lucysrausch/esp32-led-smps/3d/804-102.stp

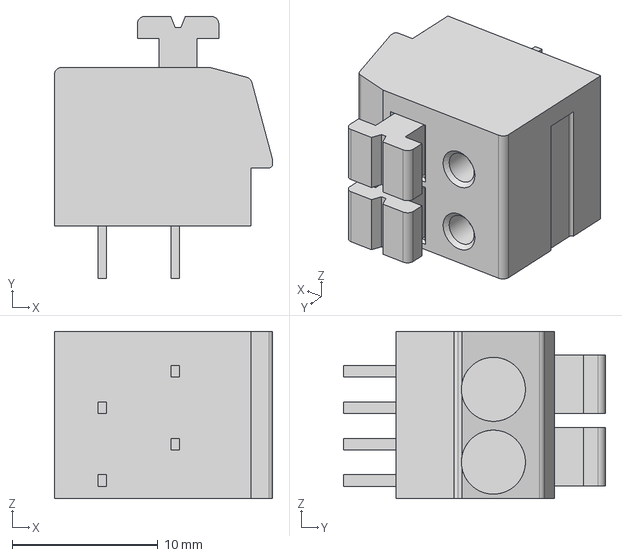
[picture p1: CAD file, 2020-04-05]
3d/804-102.stp
15.0 x 18.0 x 11.5 mm
