lucysrausch/esp32-led-smps/3d/804-103.stp

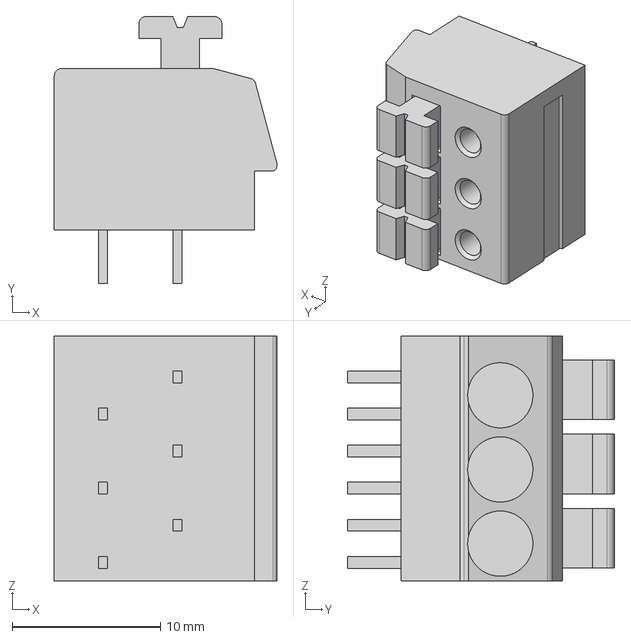
[picture p2: CAD file, 2020-04-05]
3d/804-103.stp
15.0 x 18.0 x 16.5 mm
