lucysrausch/esp32-led-smps/3d/User Library-EE25_13_7_ferrite_transformer.STEP

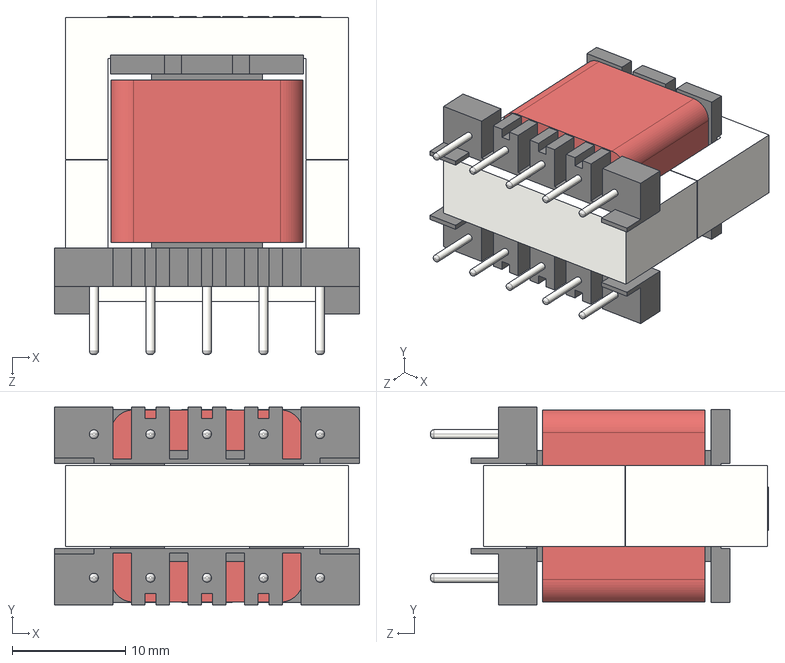
[picture p3: CAD file, 2020-04-05]
3d/User Library-EE25_13_7_ferrite_transformer.STEP
27.0 x 17.5 x 29.9 mm
