lucysrausch/esp32-led-smps/3d/radial fuse.stp

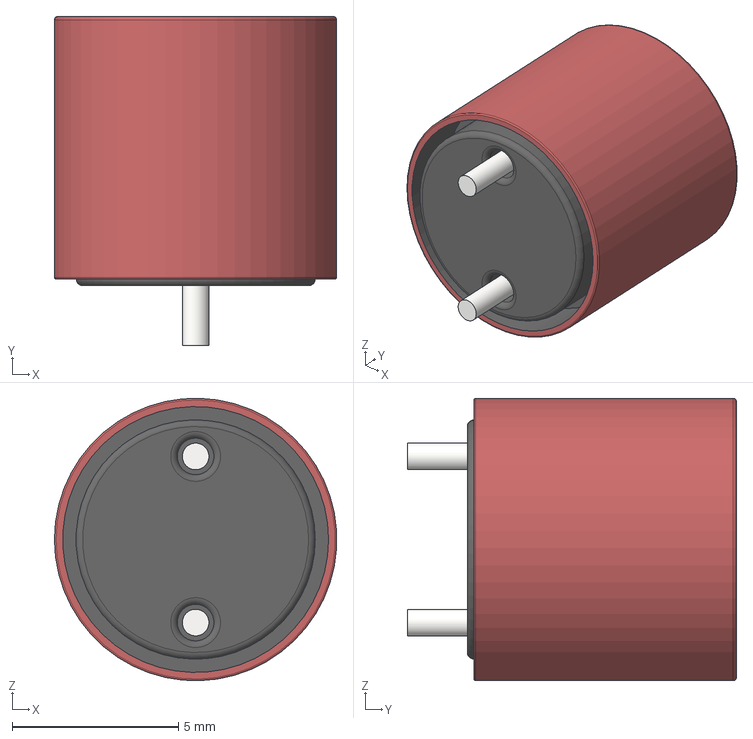
[picture p4: CAD file, 2020-04-05]
3d/radial fuse.stp
8.49 x 9.90 x 8.50 mm
