lucysrausch/esp32-led-smps/3d/User Library-UU10_5.STEP

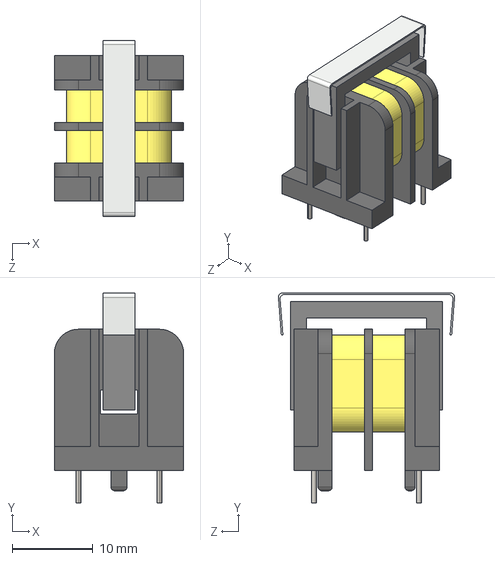
[picture p5: CAD file, 2020-04-05]
3d/User Library-UU10_5.STEP
16.0 x 26.0 x 21.8 mm
