lucysrausch/esp32-led-smps/schematic/main.pdf

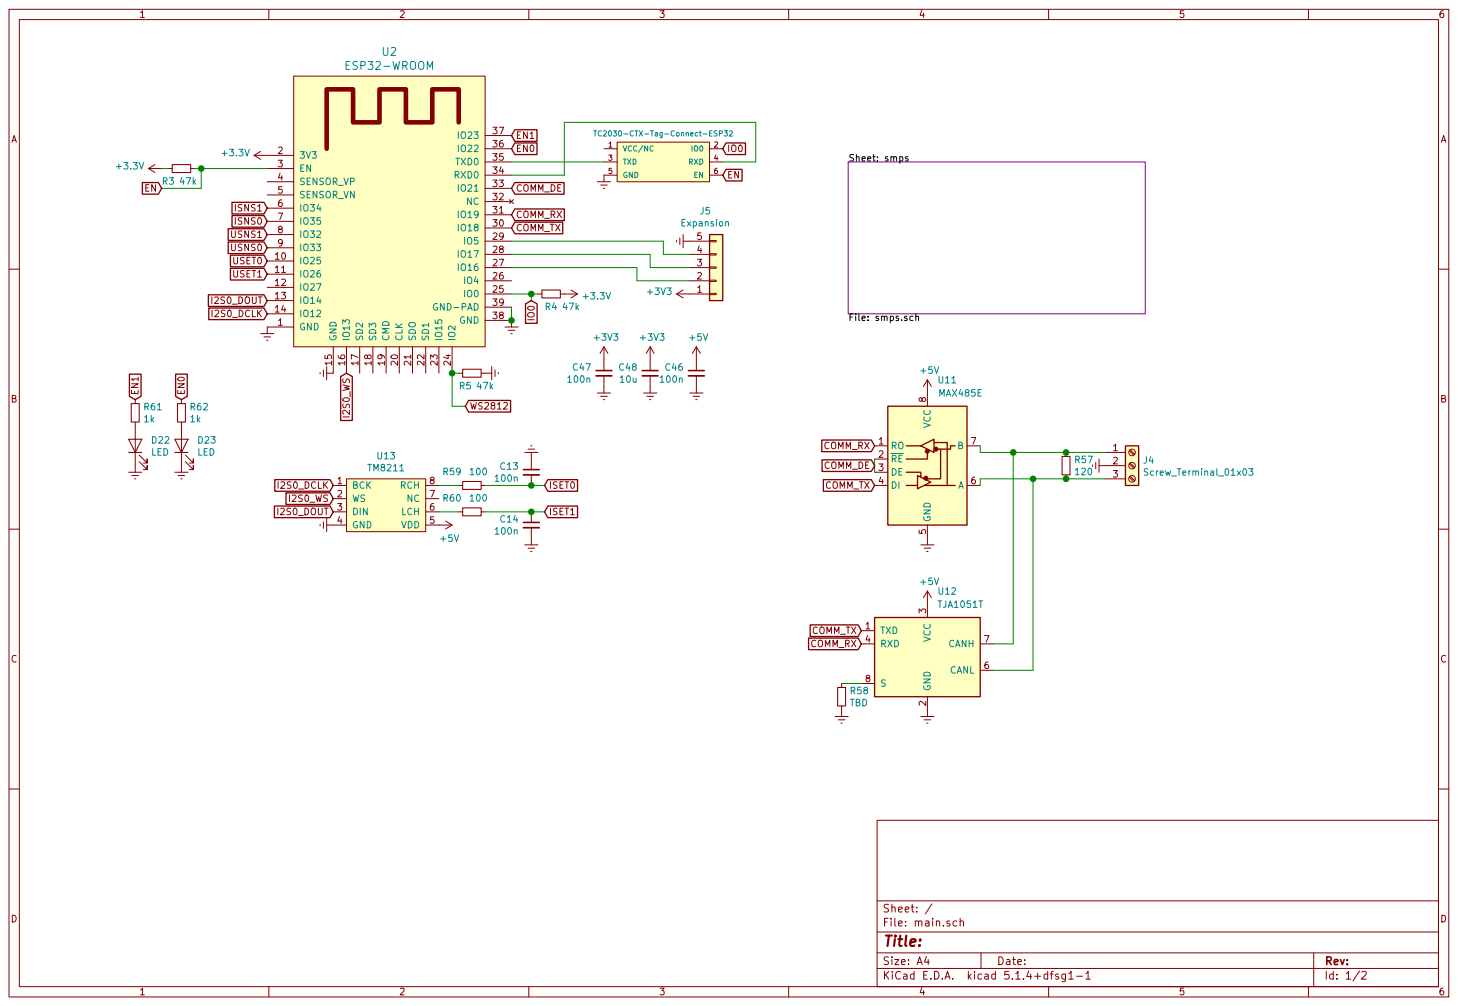
[picture p6: page 1]

Id: 1/2 Title: File: main.sch Sheet: /

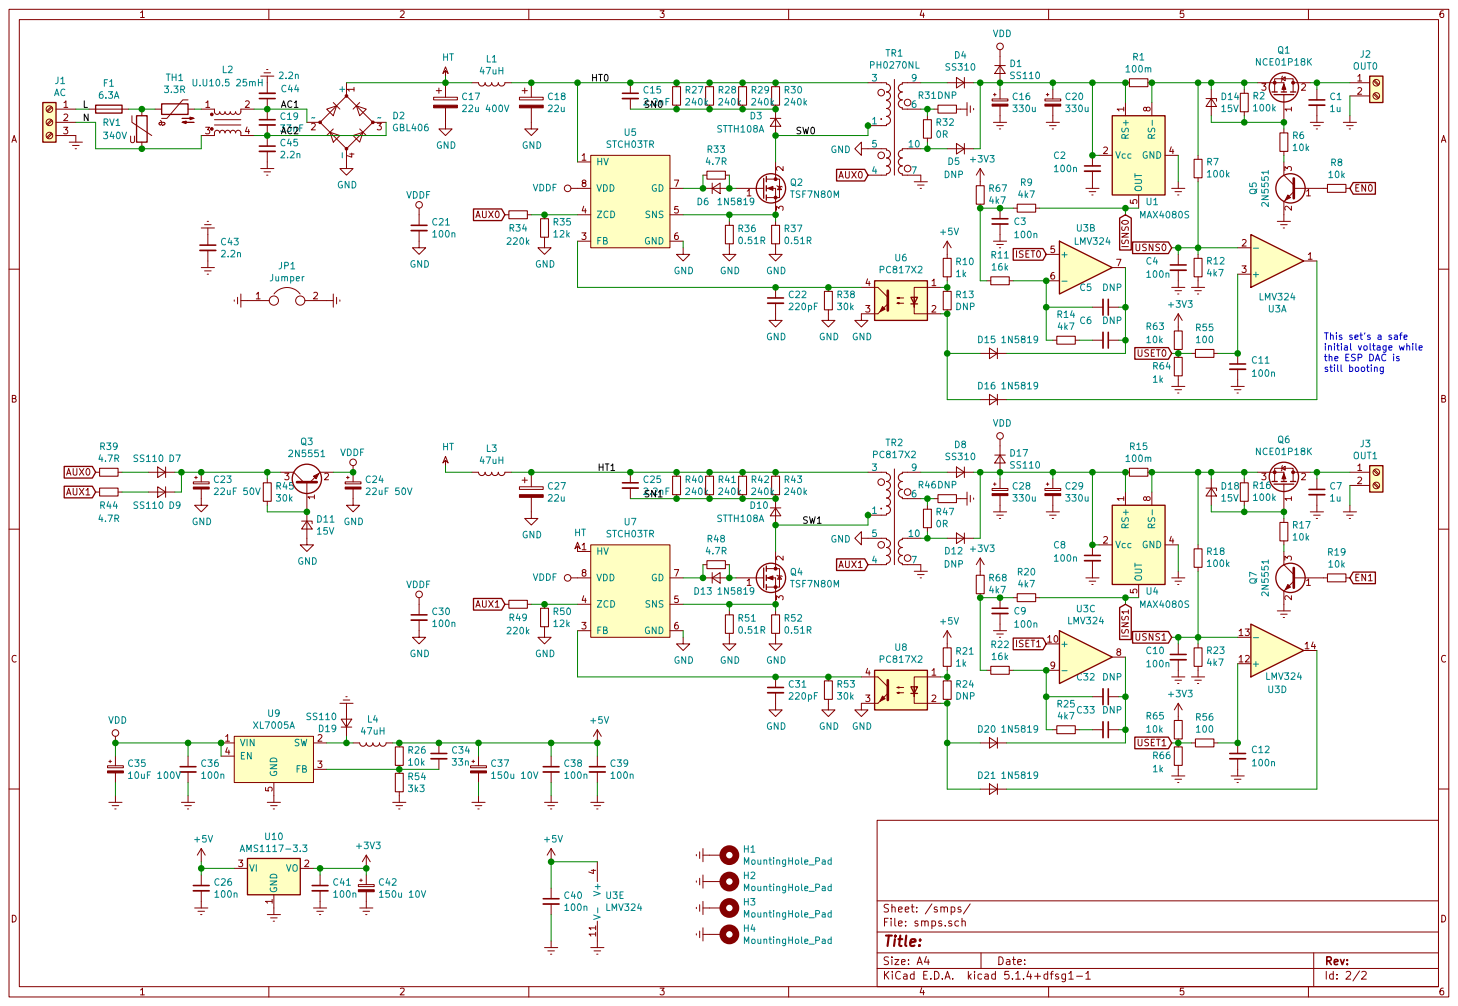
[picture p7: page 2]

initial voltage while
the ESP DAC is still booting

1 VO 2 VI 3 U10 AMS1117-3.3 GND GND
