lucysrausch/esp32-led-smps/main.kicad_pcb

## KiCad design main.kicad_pcb (2020-04-05)

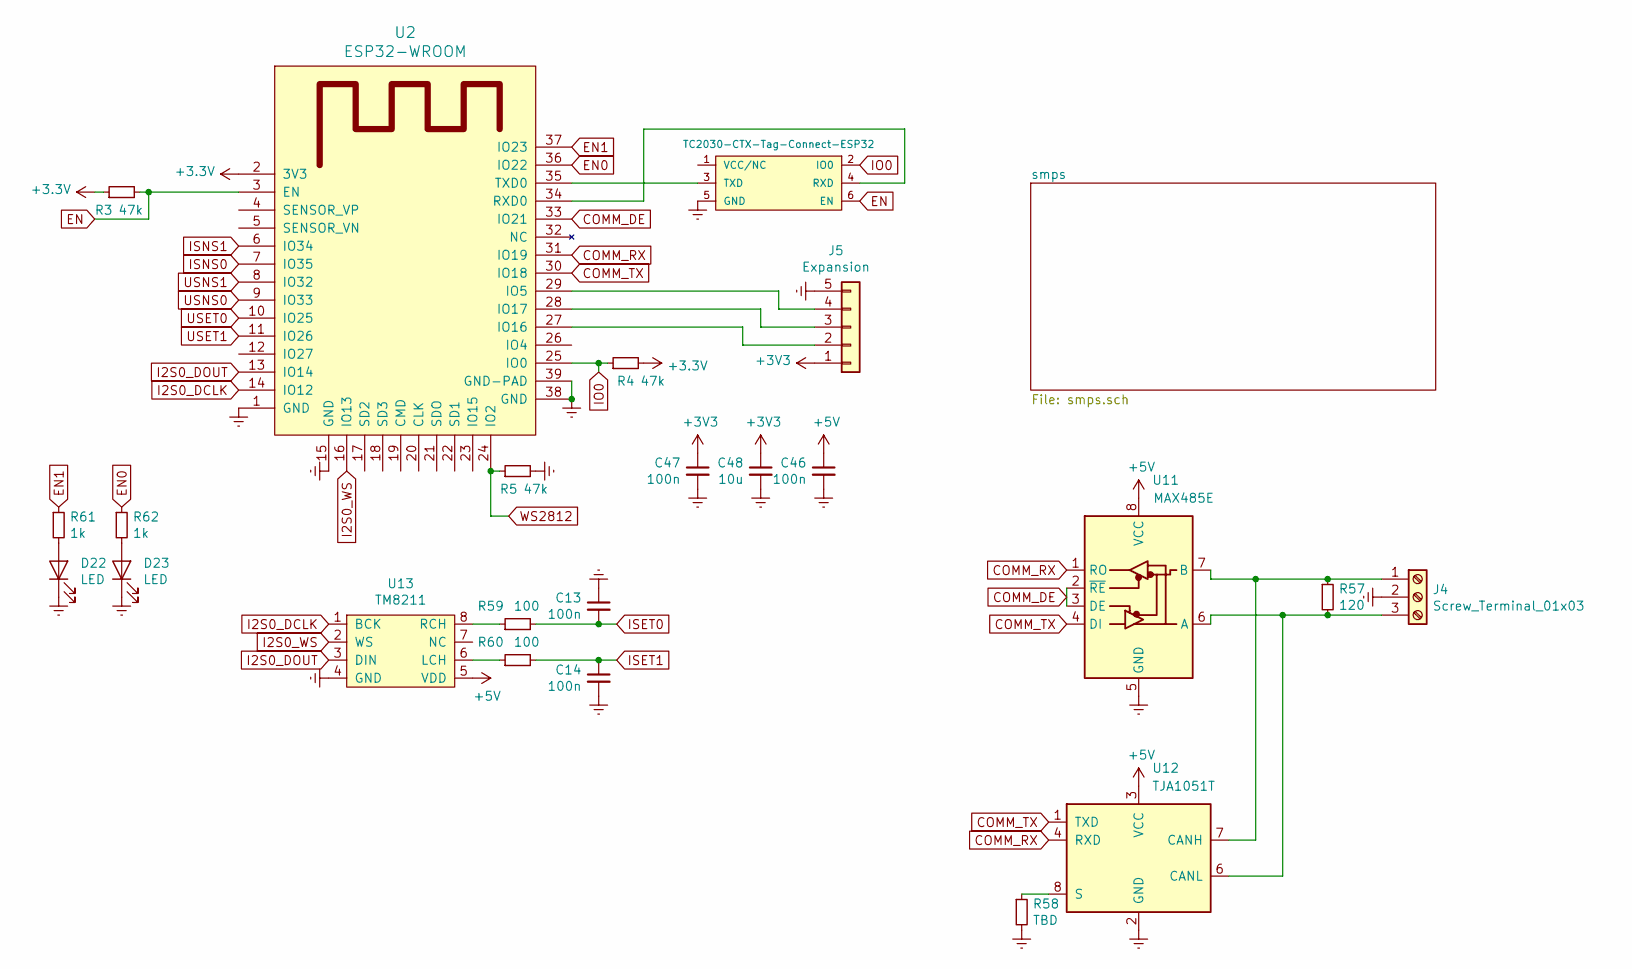
[picture p8: schematic main.sch]

Parts:
C13, C14, C46, C47: 100n; C_0603_1608Metric
C48: 10u; C_0603_1608Metric
D22, D23: LED; LED_0603_1608Metric
J4: Screw_Terminal_01x03; TerminalBlock_MetzConnect_Type086_RT03403HBLC_1x03_P3.81mm_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
J5: Expansion; PinSocket_1x05_P2.54mm_Vertical
P1: TC2030-CTX-Tag-Connect-ESP32; TC2030
R3, R4, R5: 47k; R_0603_1608Metric
R57: 120; R_0603_1608Metric
R58: TBD; R_0603_1608Metric
R59, R60: 100; R_0603_1608Metric
R61, R62: 1k; R_0603_1608Metric
U2: ESP32-WROOM; ESP32-WROOM-32
U11: MAX485E; SOIC-8_3.9x4.9mm_P1.27mm
U12: TJA1051T; SOIC-8_3.9x4.9mm_P1.27mm
U13: TM8211; SOIC-8_3.9x4.9mm_P1.27mm

Connections:
+5V: C46.1, U11.8 (VCC), U12.3 (VCC), U13.5 (VDD); also elsewhere on the board
COMM_DE: U2.33 (IO21), U11.2 (~RE), U11.3 (DE)
COMM_RX: U2.31 (IO19), U11.1 (RO), U12.4 (RXD)
COMM_TX: U2.30 (IO18), U11.4 (DI), U12.1 (TXD)
EN: P1.6 (EN), R3.2, U2.3 (EN)
EN0: R62.1, U2.36 (IO22); also elsewhere on the board
EN1: R61.1, U2.37 (IO23); also elsewhere on the board
Earth: C13.1, C14.2, C46.2, C47.2, C48.2, D22.1 (K), D23.1 (K), J4.2, J5.5, P1.5 (GND), R5.2, R58.2, U2.1 (GND), U2.15 (GND), U2.38 (GND), U2.39 (GND-PAD), U11.5 (GND), U12.2 (GND), U13.4 (GND); also elsewhere on the board
I2S0_DCLK: U2.14 (IO12), U13.1 (BCK)
I2S0_DOUT: U2.13 (IO14), U13.3 (DIN)
I2S0_WS: U2.16 (IO13), U13.2 (WS)
IO0: P1.2 (IO0), R4.1, U2.25 (IO0)
ISET0: C13.2, R59.2; also elsewhere on the board
ISET1: C14.1, R60.2; also elsewhere on the board
ISNS0: U2.7 (IO35); also elsewhere on the board
ISNS1: U2.6 (IO34); also elsewhere on the board
unnamed: D22.2 (A), R61.2
unnamed: D23.2 (A), R62.2
unnamed: J4.1, R57.1, U11.7 (B), U12.7 (CANH)
unnamed: J4.3, R57.2, U11.6 (A), U12.6 (CANL)
unnamed: J5.2, U2.27 (IO16)
unnamed: J5.3, U2.28 (IO17)
unnamed: J5.4, U2.29 (IO5)
unnamed: P1.3 (TXD), U2.35 (TXD0)
unnamed: P1.4 (RXD), U2.34 (RXD0)
unnamed: R58.1, U12.8 (S)
unnamed: R59.1, U13.8 (RCH)
unnamed: R60.1, U13.6 (LCH)
USET0: U2.10 (IO25); also elsewhere on the board
USET1: U2.11 (IO26); also elsewhere on the board
USNS0: U2.9 (IO33); also elsewhere on the board
USNS1: U2.8 (IO32); also elsewhere on the board
WS2812: R5.1, U2.24 (IO2)

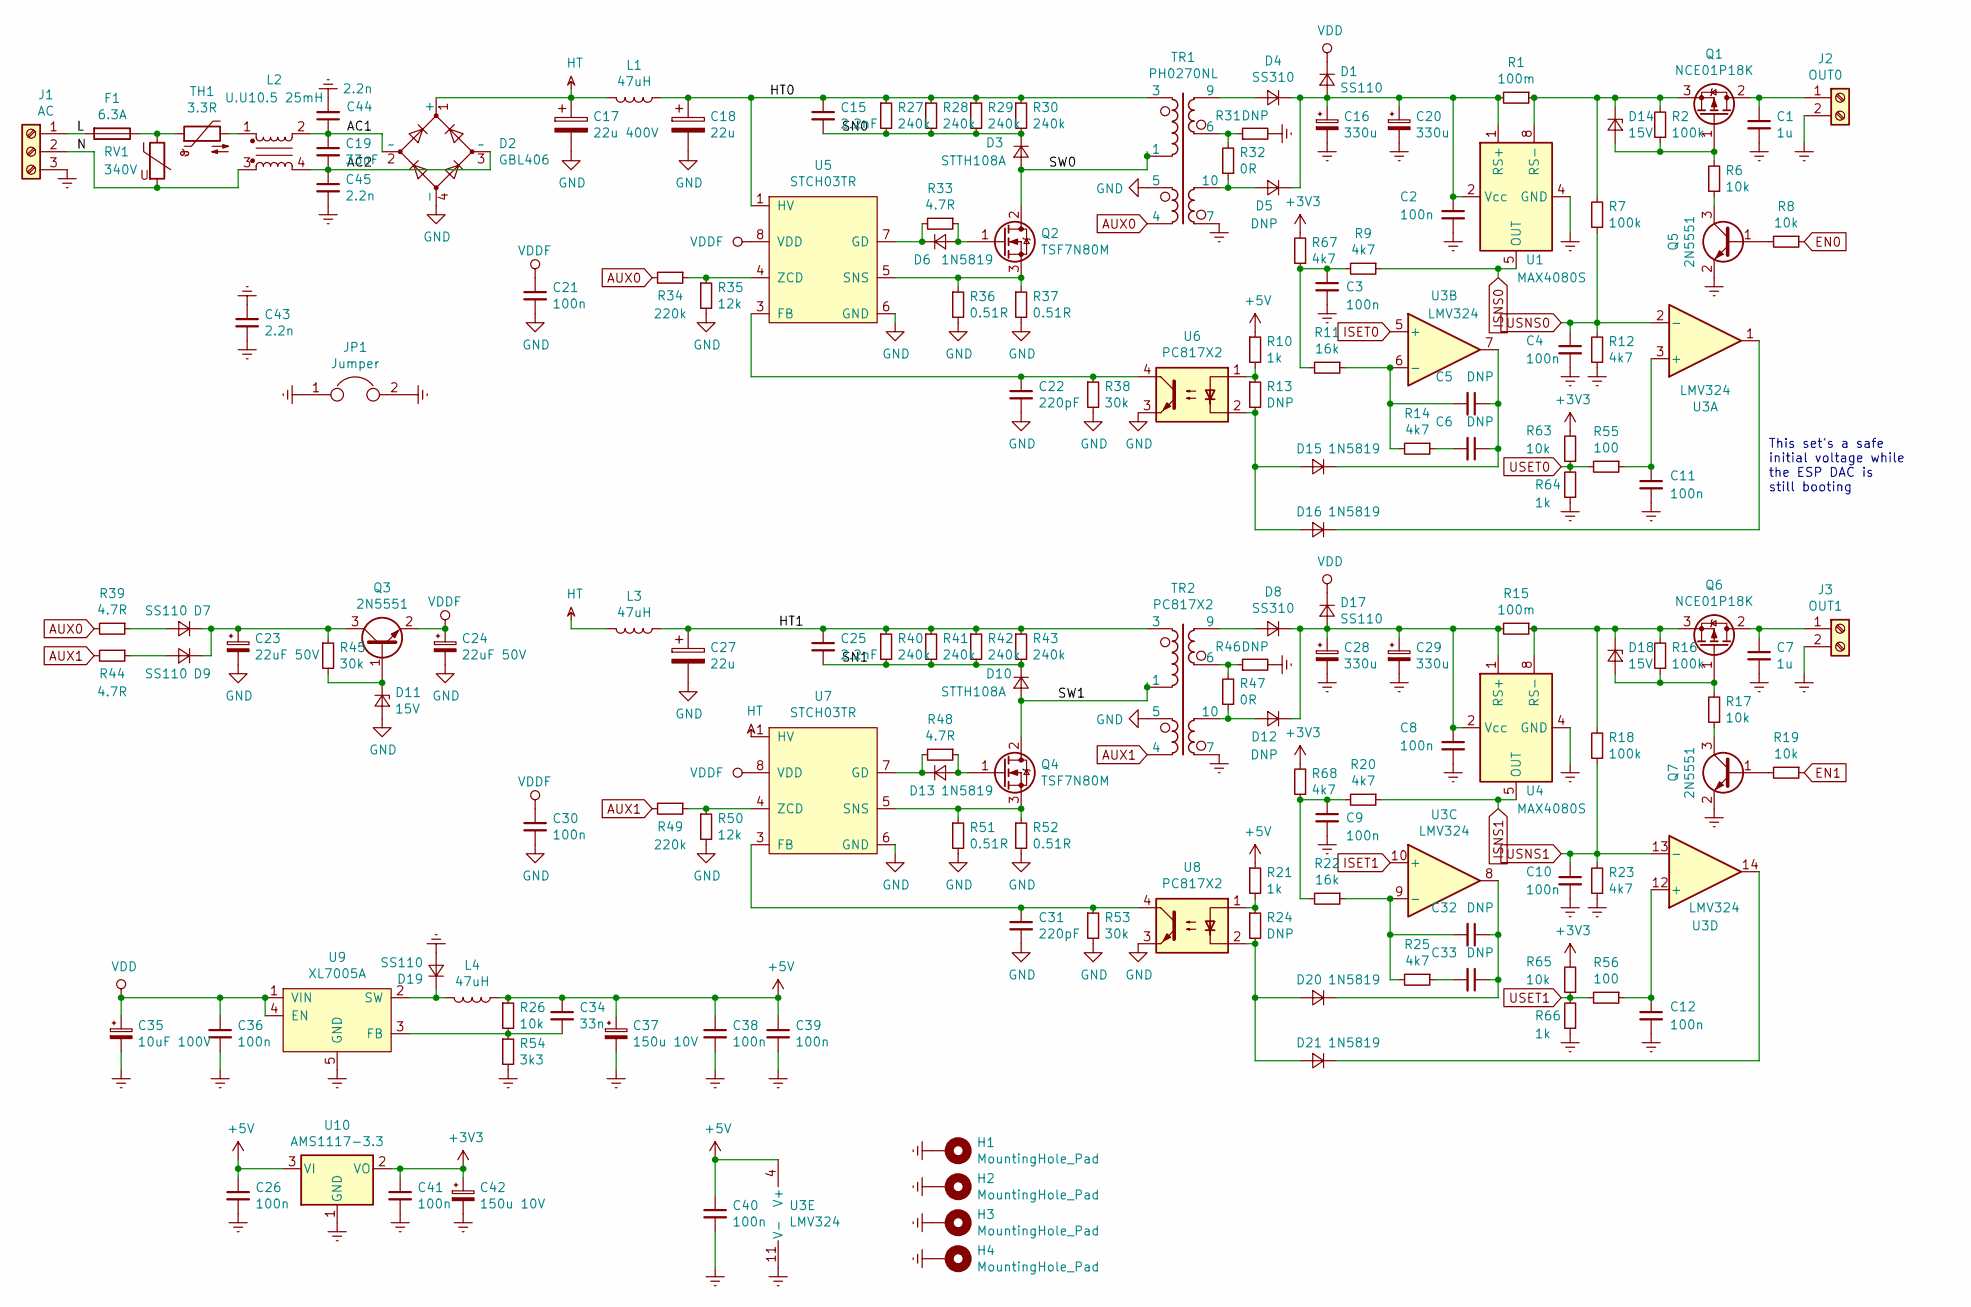
[picture p9: schematic smps.sch]

Parts:
C1, C7: 1u; C_Rect_L7.2mm_W5.5mm_P5.00mm_FKS2_FKP2_MKS2_MKP2
C2, C8, C36: 100n; C_0805_2012Metric
C3, C4, C9, C10, C11, C12, C21, C26, C30, C38, C39, C40, C41: 100n; C_0603_1608Metric
C5, C6, C32, C33: DNP; C_0603_1608Metric
C15, C25: 2.2nF; C_1206_3216Metric
C16, C20, C28, C29: 330u; CP_Radial_D16.0mm_P7.50mm
C17: 22u 400V; CP_Radial_D16.0mm_P7.50mm
C18, C27: 22u; CP_Radial_D16.0mm_P7.50mm
C19: 33nF; C_Rect_L16.5mm_W6.0mm_P15.00mm_MKT
C22, C31: 220pF; C_0603_1608Metric
C23, C24: 22uF 50V; CP_Radial_D5.0mm_P2.00mm
C34: 33n; C_0603_1608Metric
C35: 10uF 100V; CP_Radial_D5.0mm_P2.00mm
C37, C42: 150u 10V; CP_Radial_D5.0mm_P2.00mm
C43, C44, C45: 2.2n; RV_Disc_D9mm_W4mm_P5mm
D1, D7, D9, D17, D19: SS110; D_SMA
D2: GBL406; Diode_Bridge_Vishay_GBL
D3, D10: STTH108A; D_SMA
D4, D8: SS310; D_SMA
D5, D12: DNP; D_SMA
D6, D13, D15, D16, D20, D21: 1N5819; D_SOD-123
D11, D14, D18: 15V; D_SOD-123
F1: 6.3A; Fuseholder_TR5_Littelfuse_No560_No460
H1, H2, H3, H4: MountingHole_Pad; MountingHole_3.5mm_Pad_Via
J1: AC; WJ250B-3.5-3P
J2: OUT0; WJ250B-3.5-2P
J3: OUT1; WJ250B-3.5-2P
JP1: Jumper
L1, L3, L4: 47uH; L_Radial_D7.0mm_P3.00mm
L2: U.U10.5 25mH; L_CommonMode_U.U_multi
Q1, Q6: NCE01P18K; TO-252-2
Q2, Q4: TSF7N80M; TO-220-3_Vertical
Q3, Q5, Q7: 2N5551; SOT-23
R1, R15: 100m; R_1206_3216Metric
R2, R7, R16, R18: 100k; R_0603_1608Metric
R6, R8, R17, R19, R26, R63, R65: 10k; R_0603_1608Metric
R9, R12, R14, R20, R23, R25, R67, R68: 4k7; R_0603_1608Metric
R10, R21, R64, R66: 1k; R_0603_1608Metric
R11, R22: 16k; R_0603_1608Metric
R13, R24, R31, R46: DNP; R_0603_1608Metric
R27, R28, R29, R30, R40, R41, R42, R43: 240k; R_1206_3216Metric
R32, R47: 0R; R_0603_1608Metric
R33, R39, R44, R48: 4.7R; R_0603_1608Metric
R34, R49: 220k; R_0603_1608Metric
R35, R50: 12k; R_0603_1608Metric
R36, R37, R51, R52: 0.51R; R_1206_3216Metric
R38, R45, R53: 30k; R_0603_1608Metric
R54: 3k3; R_0603_1608Metric
R55, R56: 100; R_0603_1608Metric
RV1: 340V; RV_Disc_D12mm_W5.1mm_P7.5mm
TH1: 3.3R; RV_Disc_D12mm_W3.9mm_P7.5mm
TR1: PH0270NL; Pulse_PH027NL
TR2: PC817X2; Pulse_PH027NL
U1, U4: MAX4080S; SOIC-8_3.9x4.9mm_P1.27mm
U3: LMV324; SOIC-14_3.9x8.7mm_P1.27mm
U5, U7: STCH03TR; SOIC-8_3.9x4.9mm_P1.27mm
U6, U8: PC817X2; DIP-4_W7.62mm
U9: XL7005A; SOIC-8-1EP_3.9x4.9mm_P1.27mm_EP2.514x3.2mm
U10: AMS1117-3.3; SOT-223-3_TabPin2

Connections:
+5V: C26.1, C34.1, C37.1, C38.1, C39.1, C40.1, L4.1, R10.1, R21.1, R26.1, U3.4 (V+), U10.3 (VI); also elsewhere on the board
/smps/AC1: C19.1, C44.1, D2.2 (~~), L2.2
/smps/AC2: C19.2, C45.1, D2.3 (~~), L2.4
/smps/HT0: C15.1, C18.1, L1.1, R27.1, R28.1, R29.1, R30.1, TR1.3, U5.1 (HV)
/smps/HT1: C25.1, C27.1, L3.1, R40.1, R41.1, R42.1, R43.1, TR2.3
/smps/L: F1.2, J1.1
/smps/N: J1.2, L2.3, RV1.2
/smps/SN0: C15.2, D3.1 (K), R27.2, R28.2, R29.2, R30.2
/smps/SN1: C25.2, D10.1 (K), R40.2, R41.2, R42.2, R43.2
/smps/SW0: D3.2 (A), Q2.2 (D), TR1.1
/smps/SW1: D10.2 (A), Q4.2 (D), TR2.1
AUX0: R34.2, R39.2, TR1.4
AUX1: R44.2, R49.2, TR2.4
EN0: R8.1; also elsewhere on the board
EN1: R19.1; also elsewhere on the board
Earth: C1.2, C2.2, C3.2, C4.2, C7.2, C8.2, C9.2, C10.2, C11.2, C12.2, C16.2, C20.2, C26.2, C28.2, C29.2, C35.2, C36.2, C37.2, C38.2, C39.2, C40.2, C41.2, C42.2, C43.1, C43.2, C44.2, C45.2, D19.2 (A), H1.1, H2.1, H3.1, H4.1, J1.3, J2.2, J3.2, JP1.1, JP1.2, Q5.2 (E), Q7.2 (E), R12.1, R23.1, R31.2, R46.2, R54.2, R64.1, R66.1, TR1.7, TR2.7, U1.4 (GND), U3.11 (V-), U4.4 (GND), U9.5 (GND), U9.6 (GND), U9.7 (GND), U9.8 (GND), U9.9 (GND), U10.1 (GND); also elsewhere on the board
GND: C17.2, C18.2, C21.2, C22.2, C23.2, C24.2, C27.2, C30.2, C31.2, D2.4 (-), D11.2 (A), R35.2, R36.2, R37.2, R38.2, R50.2, R51.2, R52.2, R53.2, TR1.5, TR2.5, U5.6 (GND), U6.3, U7.6 (GND), U8.3
HT: C17.1, D2.1 (+), L1.2, L3.2, U7.1 (HV)
ISET0: U3.5 (+); also elsewhere on the board
ISET1: U3.10 (+); also elsewhere on the board
ISNS0: R9.1, U1.5 (OUT); also elsewhere on the board
ISNS1: R20.1, U4.5 (OUT); also elsewhere on the board
unnamed: C1.1, J2.1, Q1.2 (D)
unnamed: C3.1, R9.2, R11.2, R67.1
unnamed: C5.1, C6.1, D15.1 (K), U3.7
unnamed: C5.2, R11.1, R14.2, U3.6 (-)
unnamed: C6.2, R14.1
unnamed: C7.1, J3.1, Q6.2 (D)
unnamed: C9.1, R20.2, R22.2, R68.1
unnamed: C11.1, R55.1, U3.3 (+)
unnamed: C12.1, R56.1, U3.12 (+)
unnamed: C2.1, C16.1, C20.1, D1.2 (A), D4.1 (K), D5.1 (K), R1.2, U1.1 (RS+), U1.2 (Vcc)
unnamed: C22.1, R38.1, U5.3 (FB), U6.4
unnamed: C23.1, D7.1 (K), D9.1 (K), Q3.3 (C), R45.1
unnamed: C8.1, C28.1, C29.1, D8.1 (K), D12.1 (K), D17.2 (A), R15.2, U4.1 (RS+), U4.2 (Vcc)
unnamed: C31.1, R53.1, U7.3 (FB), U8.4
unnamed: C32.1, C33.1, D20.1 (K), U3.8
unnamed: C32.2, R22.1, R25.2, U3.9 (-)
unnamed: C33.2, R25.1
unnamed: C34.2, R26.2, R54.1, U9.3 (FB)
unnamed: D4.2 (A), TR1.9
unnamed: D5.2 (A), R32.1, TR1.10
unnamed: D6.1 (K), R33.2, U5.7 (GD)
unnamed: D6.2 (A), Q2.1 (G), R33.1
unnamed: D7.2 (A), R39.1
unnamed: D8.2 (A), TR2.9
unnamed: D9.2 (A), R44.1
unnamed: D11.1 (K), Q3.1 (B), R45.2
unnamed: D12.2 (A), R47.1, TR2.10
unnamed: D13.1 (K), R48.2, U7.7 (GD)
unnamed: D13.2 (A), Q4.1 (G), R48.1
unnamed: D14.1 (K), Q1.3 (S), R1.1, R2.2, R7.2, U1.8 (RS-)
unnamed: D14.2 (A), Q1.1 (G), R2.1, R6.2
unnamed: D15.2 (A), D16.2 (A), R13.2, U6.2
unnamed: D16.1 (K), U3.1
unnamed: D18.1 (K), Q6.3 (S), R15.1, R16.2, R18.2, U4.8 (RS-)
unnamed: D18.2 (A), Q6.1 (G), R16.1, R17.2
unnamed: D19.1 (K), L4.2, U9.2 (SW)
unnamed: D20.2 (A), D21.2 (A), R24.2, U8.2
unnamed: D21.1 (K), U3.14
unnamed: F1.1, RV1.1, TH1.1
unnamed: L2.1, TH1.2
unnamed: Q2.3 (S), R36.1, R37.1, U5.5 (SNS)
unnamed: Q4.3 (S), R51.1, R52.1, U7.5 (SNS)
unnamed: Q5.1 (B), R8.2
unnamed: Q5.3 (C), R6.1
unnamed: Q7.1 (B), R19.2
unnamed: Q7.3 (C), R17.1
unnamed: R10.2, R13.1, U6.1
unnamed: R21.2, R24.1, U8.1
unnamed: R31.1, R32.2, TR1.6
unnamed: R34.1, R35.1, U5.4 (ZCD)
unnamed: R46.1, R47.2, TR2.6
unnamed: R49.1, R50.1, U7.4 (ZCD)
USET0: R55.2, R63.1, R64.2; also elsewhere on the board
USET1: R56.2, R65.1, R66.2; also elsewhere on the board
USNS0: C4.1, R7.1, R12.2, U3.2 (-); also elsewhere on the board
USNS1: C10.1, R18.1, R23.2, U3.13 (-); also elsewhere on the board
VDD: C35.1, C36.1, D1.1 (K), D17.1 (K), U9.1 (VIN), U9.4 (EN)
VDDF: C21.1, C24.1, C30.1, Q3.2 (E), U5.8 (VDD), U7.8 (VDD)

Notes on the sheet:
This set's a safe initial voltage while the ESP DAC is still booting

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
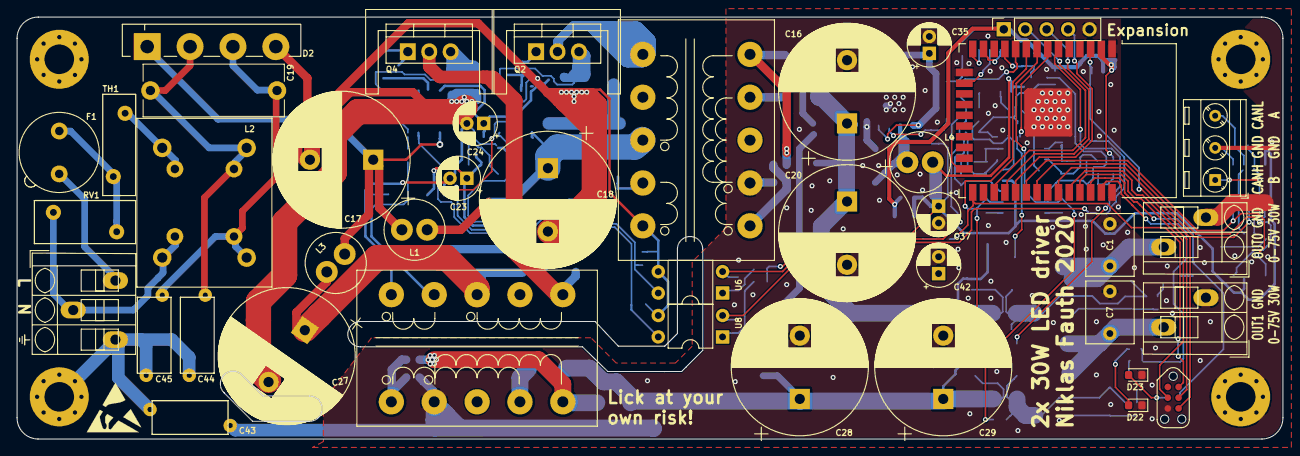
[picture p10: board main.kicad_pcb from above]

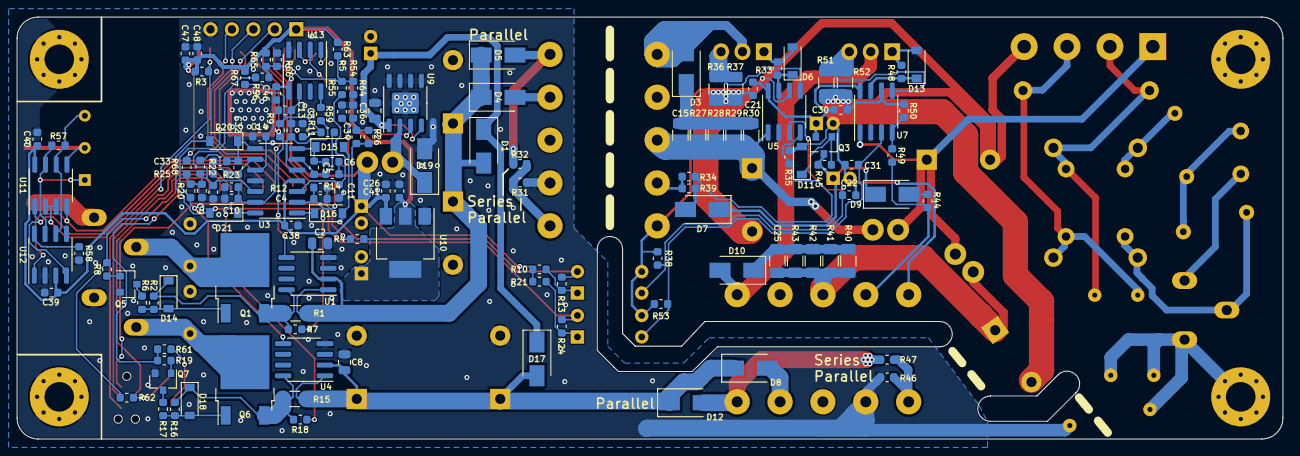
[picture p11: board main.kicad_pcb from below]

Board: 2 copper layers, 150.0 x 50.0 mm, 178 parts (133 on the bottom side), 102 nets.
