lucysrausch/esp32-led-smps/(commit log)

2020-04-05 fixed some schematic values
    [smps.sch]
2020-04-05 modified Voltage DAC bias
    [main-B_Cu.gbr, main-B_Mask.gbr, main-B_Paste.gbr, main-B_SilkS.gbr, main-Edge_Cuts.gbr, main-F_Cu.gbr, main-F_Mask.gbr, main-F_Paste.gbr]
